kimka1656/2025ESWContest_free_1109/README.md

# 스마트 헬스 서포터



**스마트 헬스 서포터**는 저비용 스마트 운동 디바이스 및 안드로이드 앱입니다.  
기존 아날로그 운동기구에 스마트 기능을 결합하여 운동 데이터를 수집, 분석하고 실시간 피드백을 제공합니다.  
현재 급성장 중인 디지털 헬스케어 시장을 겨냥하여, 비용 부담 없이도 체계적인 운동 관리가 가능합니다.

---

## 🏋️‍♂️ 핵심 기능

| 기능 | 설명 |
| --- | --- |
| **운동 횟수 자동 기록** | 세트 수와 횟수를 앱에 입력하면, 디바이스가 운동 시 자동으로 횟수를 인식하고 기록 |
| **운동 균형 감지** | 좌우 힘의 불균형을 감지하고 사용자에게 실시간 알림 제공 |
| **운동 속도 피드백** | 동작 속도를 분석하여 너무 빠르거나 느린 경우 피드백 제공 |
| **운동 루틴 관리** | 날짜별 누적 데이터를 분석해 체계적인 운동 계획 제공 |

---

## 🔗 디바이스 연결

- **연결 방식**: 블루투스
- **데이터 전송**: 실시간 운동 데이터 전송 및 앱에서 즉시 피드백

---

## 👥 팀 소개

- **팀명**: 파워서플라이
- **팀원**:

  |  이름  | 역할                                         |        연락처         |
  | :----: | -------------------------------------------- | :-------------------: |
  | 박경균 | 팀장, 하드웨어 설계, 운동 횟수 알고리즘 개발 |   pgg523@naver.com    |
  | 김재현 | 하드웨어 통신 연구 및 개발                   |  marcus603@naver.com  |
  | 박서현 | 안드로이드 앱 개발                           | psh22112100@gmail.com |
  | 김강일 | 전반적인 하드웨어 알고리즘 개발              |  kimka1656@naver.com  |

---

## 🛠 개발 환경

### 하드웨어

- **MCU**: Arduino Nano 33 BLE
- **배터리**: 1000mAh 리튬 폴리머

### 소프트웨어

- **Android Compile SDK Version**: 36 (Android 15)
- **Target SDK Version**: 36 (Android 15)
- **Minimum SDK Version**: 30 (Android 11)
- **Java Version**: 11
- **Kotlin JVM Target**: 11

---

## 📂 프로젝트 구조

- [android](./android/): 안드로이드 앱 소스
- [circuit](./circuit/): 회로 설계 및 기기 설계
- [counting_machine_ESP32](./counting_machine_ESP32/): 초기 IMU 센서 테스트 (Arduino ESP32)
- [counting_machine_nano33BLE](./counting_machine_nano33BLE/): 최종 운동 횟수 측정 디바이스 (Arduino Nano 33 BLE)

---

## 📑 주요 개발 문서

- [회로 설계 및 기기 설계](./circuit/README.md)
- [앱 기능 요구사항 분석](./android/기능요구사항.md)

---

## ▶️ 시연 영상

https://youtu.be/-8zdW98ElVk
