kimka1656/2025ESWContest_free_1109/android/기능요구사항.md

# 기능 요구사항

**1. Daily 운동 계획 작성**

- 사용자는 오늘 할 운동명, 횟수, 세트, 1회 왕복시간, 세트별 쉬는시간을 작성합니다
- 애플리케이션은 사용자가 작성한 내용을 바탕으로 오늘 운동 내용을 관리합니다

**2. 디바이스 측정 내용 기록**

- 디바이스의 운동 시작 신호를 수신합니다.
- 디바이스에서 측정한 운동 횟수를 기록합니다
- 디바이스에서 측정한 운동 속도를 기록합니다
- 현재 운동 횟수와 달성 세트를 보여줍니다.

**3. 운동 세트별 쉬는시간 관리**

- 한 세트가 끝나면 사용자가 작성한 쉬는시간을 기반으로 타이머를 보여줍니다
- 쉬는시간이 종료되면 달성세트를 업데이트하고 디바이스의 운동 시작 신호를 대기합니다

**4. 운동 결과 분석**

- 사용자가 작성한 운동이 모두 끝나면 운동별 달성 기록들을 보여줍니다

## 요구사항 분석

### User Flow Chart

```mermaid
graph TB
    StartingApp((앱 실행))
    Start[오늘 운동 계획 작성]
    B[디바이스 측정 시작 대기]
    C[운동 횟수 및 속도 측정]
    isLastSet{마지막 세트인가?}
    Timer[쉬는 시간 타이머 측정]
    isLastWO{마지막 운동인가?}
    Finish((운동 결과 출력))

    StartingApp --> Start
    Start --> |시작 버튼 click| B
    B --> |디바이스 시작 signal 수신| C
    C --> |"목표 횟수 달성(자동)"| isLastSet
    C --> |남은 횟수 skip 버튼 click| isLastSet

    isLastSet -- No --> Timer
    isLastSet -- Yes --> isLastWO

    Timer --> |타이머 종료| C

    isLastWO -- No --> B
    isLastWO -- Yes --> Finish

    style StartingApp fill:#d9f7be,stroke:#389e0d,color:#000000
    style Finish fill:#d9f7be,stroke:#389e0d,color:#000000
    style isLastSet fill:#fff1b8,stroke:#d46b08,color:#000000
    style isLastWO fill:#fff1b8,stroke:#d46b08,color:#000000
```

### 디바이스 통신 Flow

디바이스와의 통신은 저전력 블루투스(BLE)를 기본으로 한다.

- 전제조건: 사용자가 앱의 시작버튼을 누른 후에만 수신할 수 있다.

- System flow chart

  ```mermaid
  graph LR
      Start --> WaitingConnection
      WaitingConnection --> |디바이스 연결|WaitingSignal
      WaitingSignal--> |시작 signal 수신|StartWorkOut

      Start[App 시작 버튼 클릭]
      WaitingConnection[블루투스 연결 대기]
      WaitingSignal[시작 signal 대기]
      StartWorkOut[운동 측정 시작]
  ```

- UI 예시

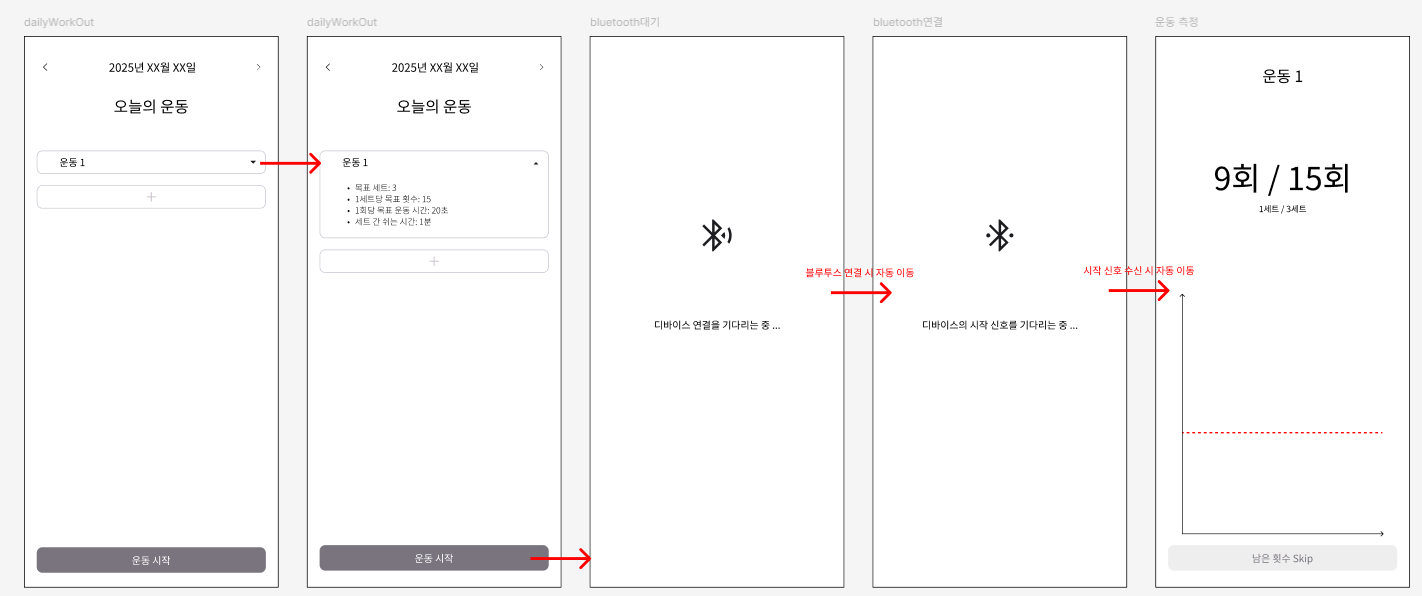
[picture p10: android/docs_image/시작통신UI예시.png]
