kimka1656/2025ESWContest_free_1109/circuit/docs_images/Arduino_Nano33_BLE_PinNumber.png

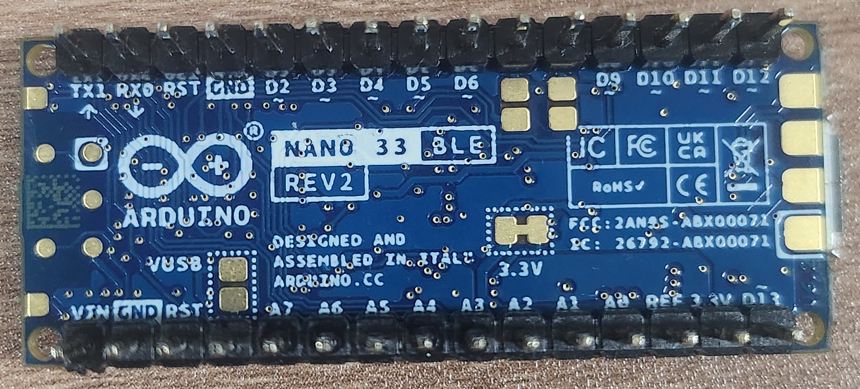
circuit/docs_images/Arduino_Nano33_BLE_PinNumber.png
