kimka1656/2025ESWContest_free_1109/counting_machine_ESP32/FireBeetle 2 ESP32-E.jpg

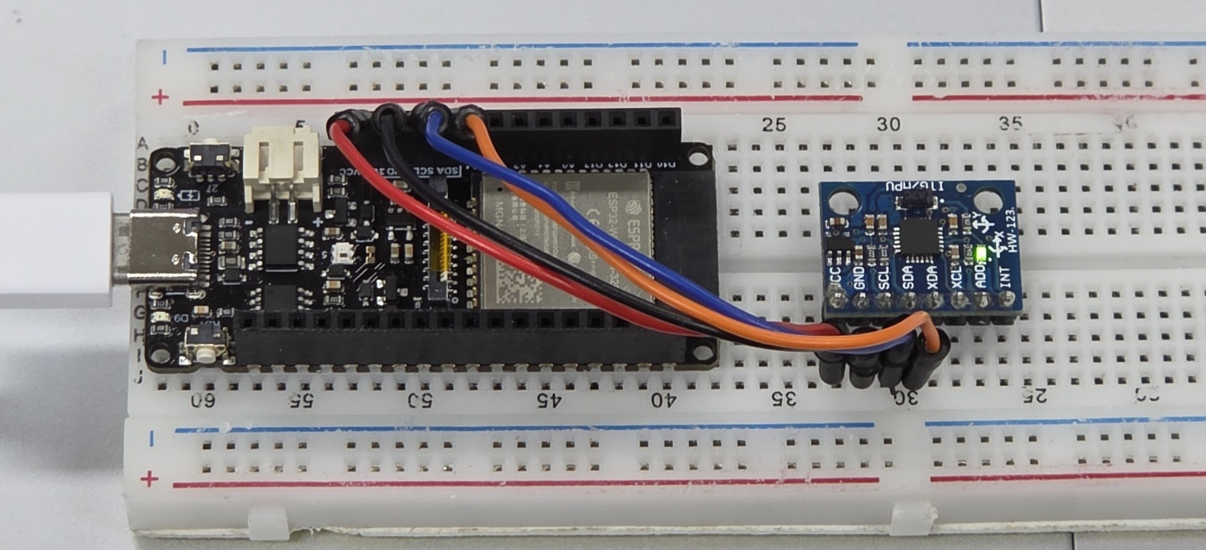
counting_machine_ESP32/FireBeetle 2 ESP32-E.jpg
